MonkeyBoy122/ThermalCamara/dock_back.png

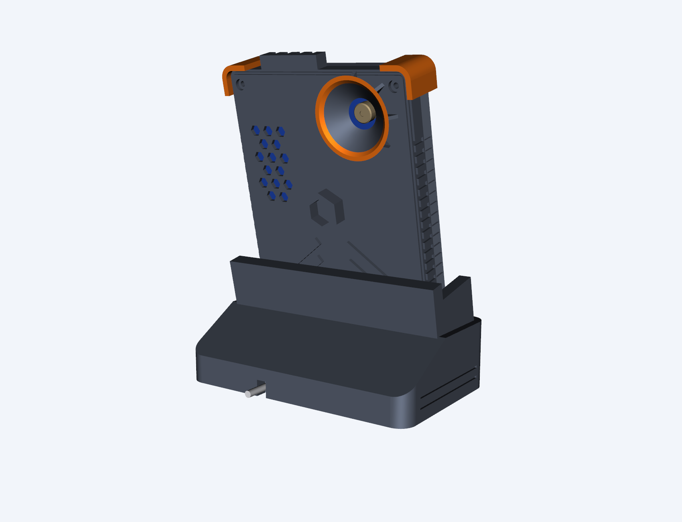
dock_back.png
