MonkeyBoy122/ThermalCamara/dock_front.png

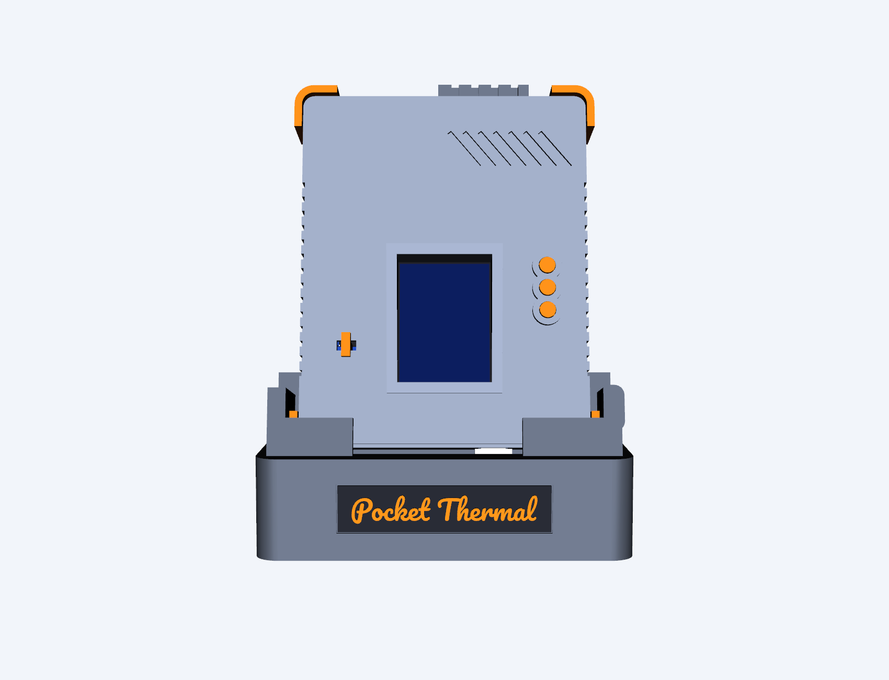
dock_front.png
