MonkeyBoy122/ThermalCamara/dock_side.png

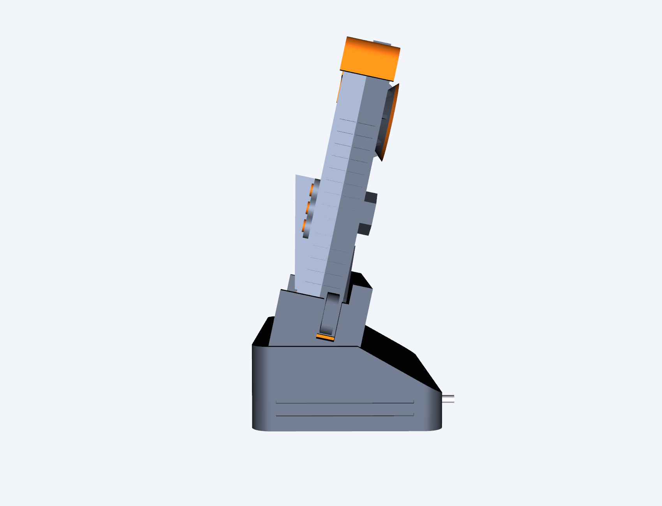
dock_side.png
