MonkeyBoy122/ThermalCamara/dock_underside.png

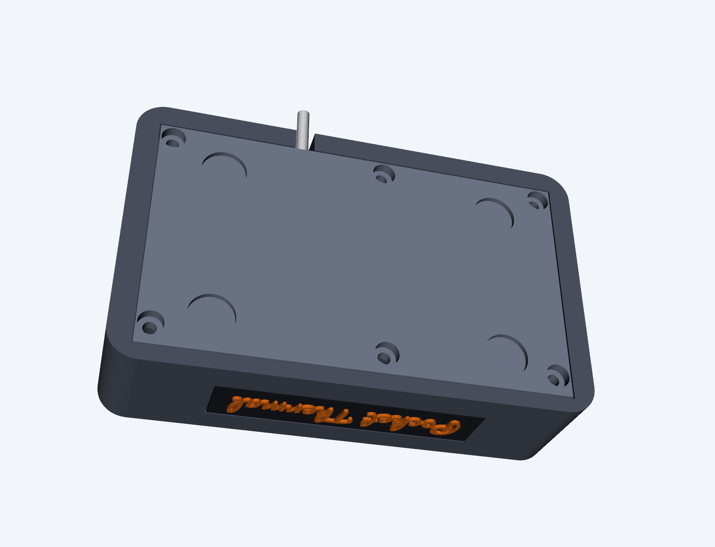
dock_underside.png
