MonkeyBoy122/ThermalCamara/enclosure_hero.png

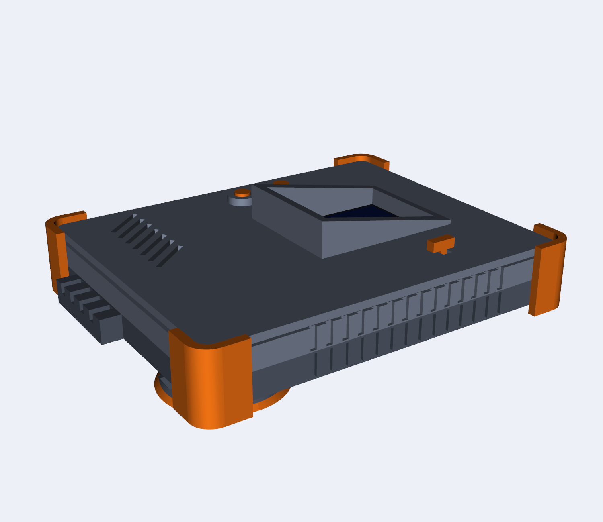
enclosure_hero.png
