MonkeyBoy122/ThermalCamara/figure12_3d_render.png

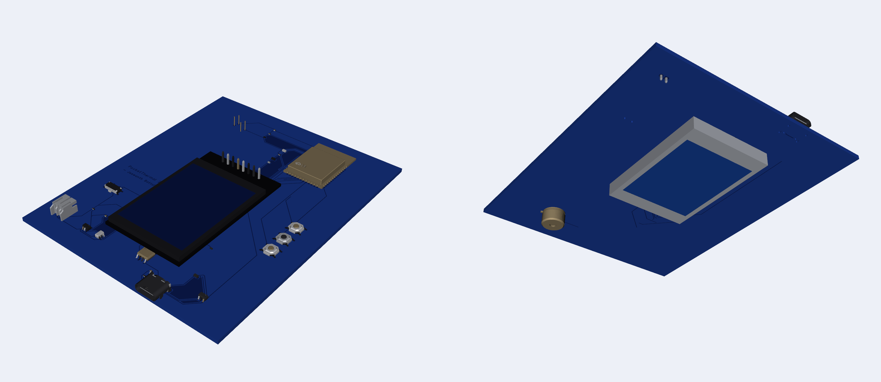
figure12_3d_render.png
