MonkeyBoy122/ThermalCamara/images/dock/empty.png

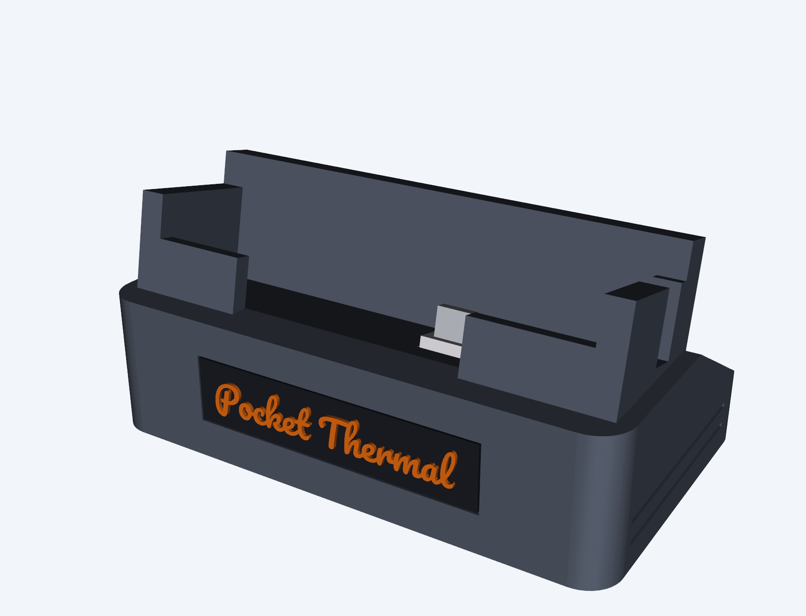
images/dock/empty.png
