MonkeyBoy122/ThermalCamara/images/dock/exploded.png

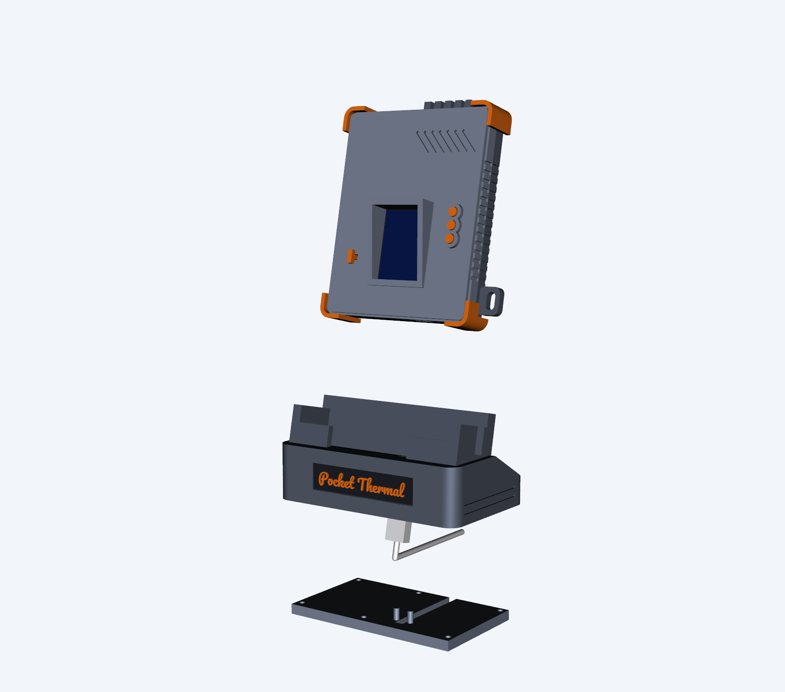
images/dock/exploded.png
