MonkeyBoy122/ThermalCamara/images/dock/nameplate.png

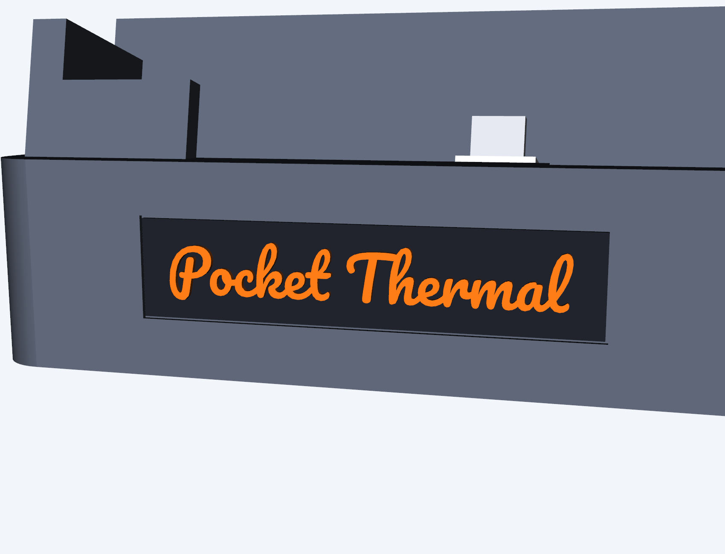
images/dock/nameplate.png
