MonkeyBoy122/ThermalCamara/images/dock/section.png

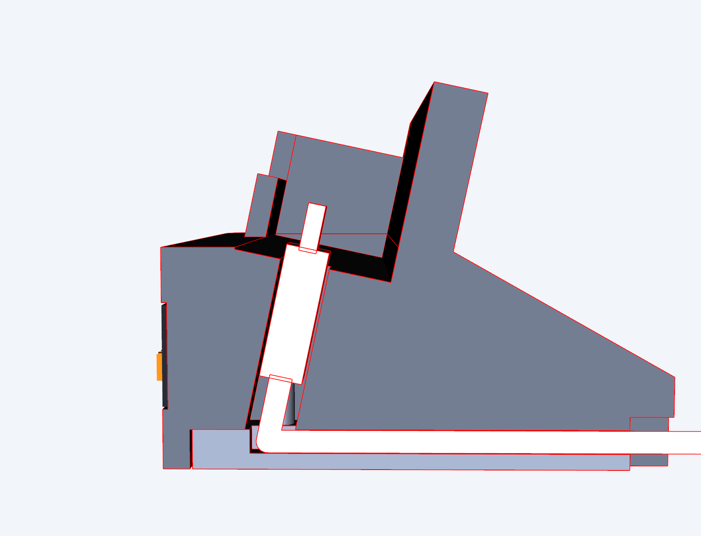
images/dock/section.png
