MonkeyBoy122/ThermalCamara/images/enclosure/back.png

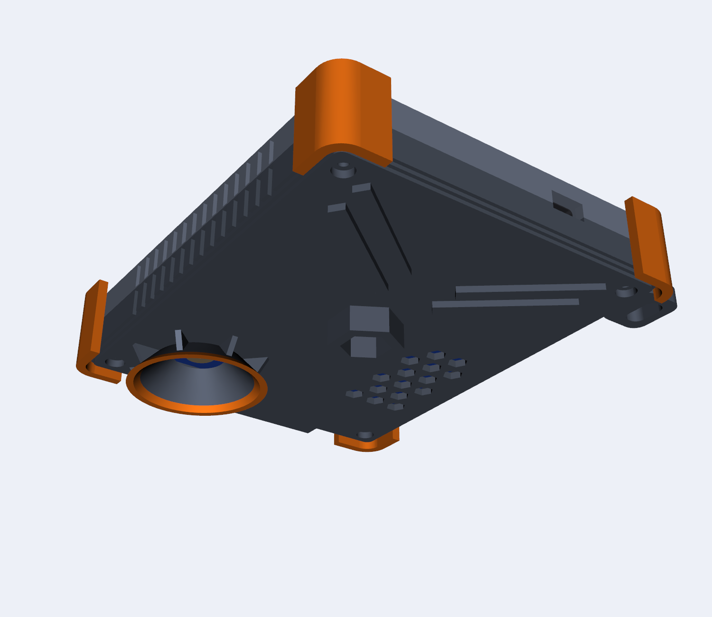
images/enclosure/back.png
