MonkeyBoy122/ThermalCamara/images/enclosure/exploded.png

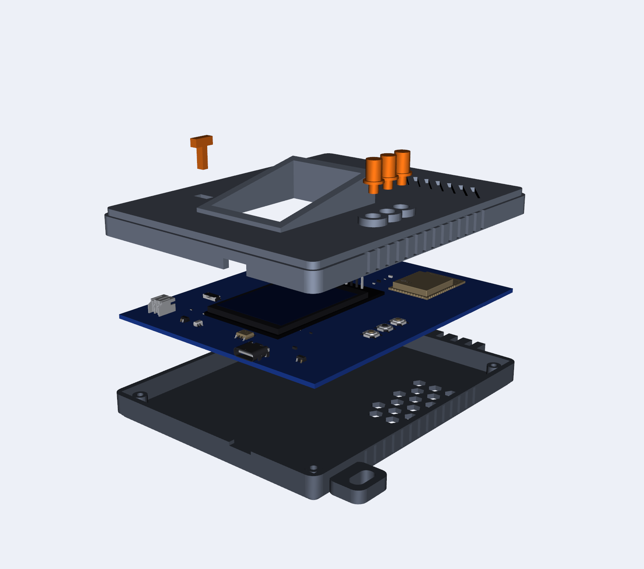
images/enclosure/exploded.png
