MonkeyBoy122/ThermalCamara/images/enclosure/front.png

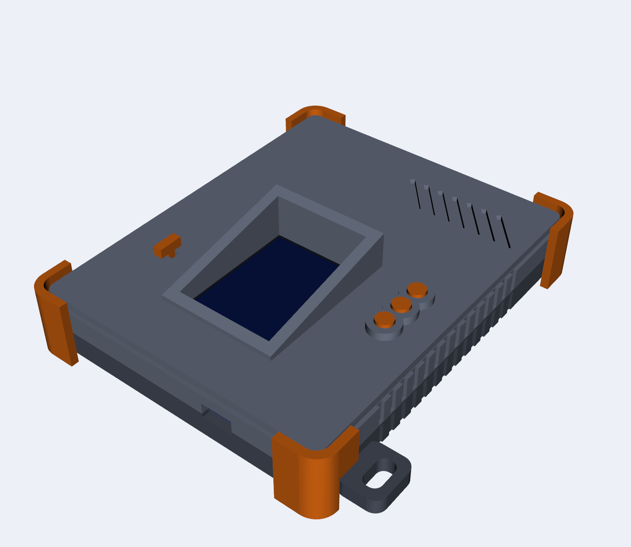
images/enclosure/front.png
