MonkeyBoy122/ThermalCamara/BOM.md

# PocketThermal – bill of materials

<!-- Generated by Half Life from project cmuvae94e0foc01sm9pq8vcqa. Edits here are overwritten on the next sync. -->
<!-- Generated: 2026-10-11T19:07:40.587Z -->

> [!NOTE]
> This parts list is mirrored from [Half Life](https://halflife.hackclub.com). Editing it here will not change the platform's copy, and the next sync overwrites this file.

| Week | Tier | Parts funding |
| --- | --- | --- |
| Week 1 | Tier 3 | $100.00 |

| Part | What it's for | Qty | Unit | Total | Vendor |
| --- | --- | --- | --- | --- | --- |
| [ESP32-S3-WROOM-1-N8R2](https://www.lcsc.com/product-detail/C2913204.html) | Wi-Fi and the main loop | 1 | $4.68 | $4.68 | [LCSC](https://www.lcsc.com/product-detail/C2913204.html) |
| [2.0" ST7789 240×320 IPS LCD](https://www.amazon.com/dp/B0H6VZD3LW) | Shows the thermal image | 1 | $7.98 | $7.98 | [Amazon](https://www.amazon.com/dp/B0H6VZD3LW) |
| [DW01A (SOT-23-6)](https://www.lcsc.com/product-detail/C359989.html) | Battery protection controller | 1 | $0.51 | $0.51 | [LCSC](https://www.lcsc.com/product-detail/C359989.html) |
| [503450 LiPo 3.7 V ~1200 mAh, JST-PH](https://www.amazon.com/dp/B09FLG39NX?plpRedirect=mhFallback) | Battery | 1 | $10.99 | $10.99 | [Amazon](https://www.amazon.com/dp/B09FLG39NX?plpRedirect=mhFallback) |
| [TP4056-42-ESOP8](https://www.lcsc.com/product-detail/C16581.html) | Charges the battery from USB-C | 1 | $0.93 | $0.93 | [LCSC](https://www.lcsc.com/product-detail/C16581.html) |
| [FS8205A (SOT-23-6)](https://www.lcsc.com/product-detail/C908265.html) | Battery protection MOSFET pair | 1 | $0.58 | $0.58 | [LCSC](https://www.lcsc.com/product-detail/C908265.html) |
| [AP2112K-3.3TRG1](https://www.lcsc.com/product-detail/C51118.html) | 3.3 V regulator | 1 | $0.86 | $0.86 | [LCSC](https://www.lcsc.com/product-detail/C51118.html) |
| [USBLC6-2SC6](https://www.lcsc.com/product-detail/C7519.html) | USB data line surge protection | 1 | $0.89 | $0.89 | [LCSC](https://www.lcsc.com/product-detail/C7519.html) |
| [USB-C 16-pin connector](https://www.lcsc.com/product-detail/C2765186.html) | Charging and USB programming | 1 | $1.43 | $1.43 | [LCSC](https://www.lcsc.com/product-detail/C2765186.html) |
| [JST S2B-PH-K-S(LF)(SN)](https://www.lcsc.com/product-detail/C173752.html) | Battery connector | 1 | $0.80 | $0.80 | [LCSC](https://www.lcsc.com/product-detail/C173752.html) |
| [MSK12C02 slide switch](https://www.lcsc.com/product-detail/C431540.html) | Power switch | 1 | $0.54 | $0.54 | [LCSC](https://www.lcsc.com/product-detail/C431540.html) |
| [5.1×5.1 mm SMD tact switch](https://www.lcsc.com/search?q=5.1x5.1+smd+tact+switch+4pin) | Trigger and menu buttons | 3 | $0.05 | $0.15 | [LCSC](https://www.lcsc.com/search?q=5.1x5.1+smd+tact+switch+4pin) |
| [0603 LED (red, green)](https://www.lcsc.com/search?q=0603+led) | Charging and standby indicators | 2 | $0.99 | $1.98 | [LCSC](https://www.lcsc.com/search?q=0603+led) |
| [8-pin 2.54 mm female header](https://www.lcsc.com/search?q=2.54mm+8p+female+header) | Plugs the LCD into the board | 1 | $0.15 | $0.15 | [LCSC](https://www.lcsc.com/search?q=2.54mm+8p+female+header) |
| [5.1 kΩ 0402 resistor](https://www.lcsc.com/search?q=5.1k+0402+resistor) | USB-C CC1 and CC2 (R1, R2) | 2 | $0.12 | $0.24 | [LCSC](https://www.lcsc.com/search?q=5.1k+0402+resistor) |
| [1 kΩ 0402 resistor](https://www.lcsc.com/search?q=1k+0402+resistor) | LED current limit (R4, R5) | 2 | $0.18 | $0.36 | [LCSC](https://www.lcsc.com/search?q=1k+0402+resistor) |
| [10 kΩ 0402 resistor](https://www.lcsc.com/search?q=10k+0402+resistor) | ESP32 reset pull-up (R8) | 1 | $0.34 | $0.34 | [LCSC](https://www.lcsc.com/search?q=10k+0402+resistor) |
| [100 kΩ 0402 resistor](https://www.lcsc.com/search?q=100k+0402+resistor) | Battery voltage divider (R9, R10) | 2 | $0.18 | $0.36 | [LCSC](https://www.lcsc.com/search?q=100k+0402+resistor) |
| [4.7 kΩ 0402 resistor](https://www.lcsc.com/search?q=4.7k+0402+resistor) | I2C pull-ups (R11, R12) | 2 | $0.17 | $0.34 | [LCSC](https://www.lcsc.com/search?q=4.7k+0402+resistor) |
| [100 nF 0402 capacitor](https://www.lcsc.com/search?q=100nF+0402+capacitor) | Decoupling and filtering (C1, C6, C7, C9, C10) | 5 | $0.09 | $0.45 | [LCSC](https://www.lcsc.com/search?q=100nF+0402+capacitor) |
| [Custom 2-layer PCB (5 boards)](https://jlcpcb.com) | The board itself | 1 | $8.50 | $8.50 | [JLCPCB](https://jlcpcb.com) |
| [2 kΩ 0402 resistor](https://www.lcsc.com/search?q=2k+0402+resistor) | Charge current set and battery protection (R3, R7) | 2 | $0.17 | $0.34 | [LCSC](https://www.lcsc.com/search?q=2k+0402+resistor) |
| [100 Ω 0402 resistor](https://www.lcsc.com/search?q=100R+0402+resistor) | Battery protection supply (R6) | 1 | $0.34 | $0.34 | [LCSC](https://www.lcsc.com/search?q=100R+0402+resistor) |
| [10 µF 0603 capacitor](https://www.lcsc.com/search?q=10uF+0603+capacitor) | Power decoupling (C2–C5, C8) | 5 | $0.12 | $0.60 | [LCSC](https://www.lcsc.com/search?q=10uF+0603+capacitor) |
| [MLX90640ESF-BAB-000-TU](https://www.lcsc.com/product-detail/Image-Sensors_Melexis-MLX90640ESF-BAB-000-TU_C488251.html) | 32×24 thermal image sensor | 1 | $23.38 | $23.38 | [LCSC](https://www.lcsc.com/product-detail/Image-Sensors_Melexis-MLX90640ESF-BAB-000-TU_C488251.html) |
| **Parts subtotal** | — | — | — | **$67.72** | — |
| **Tax & shipping** | — | — | — | **$32.15** | — |
| **Total** | — | — | — | **$99.87** | — |

$0.13 left of the tier's funding.
