MonkeyBoy122/ThermalCamara/pcb/PCB_layout_and_BOM_2026-10-10.pdf

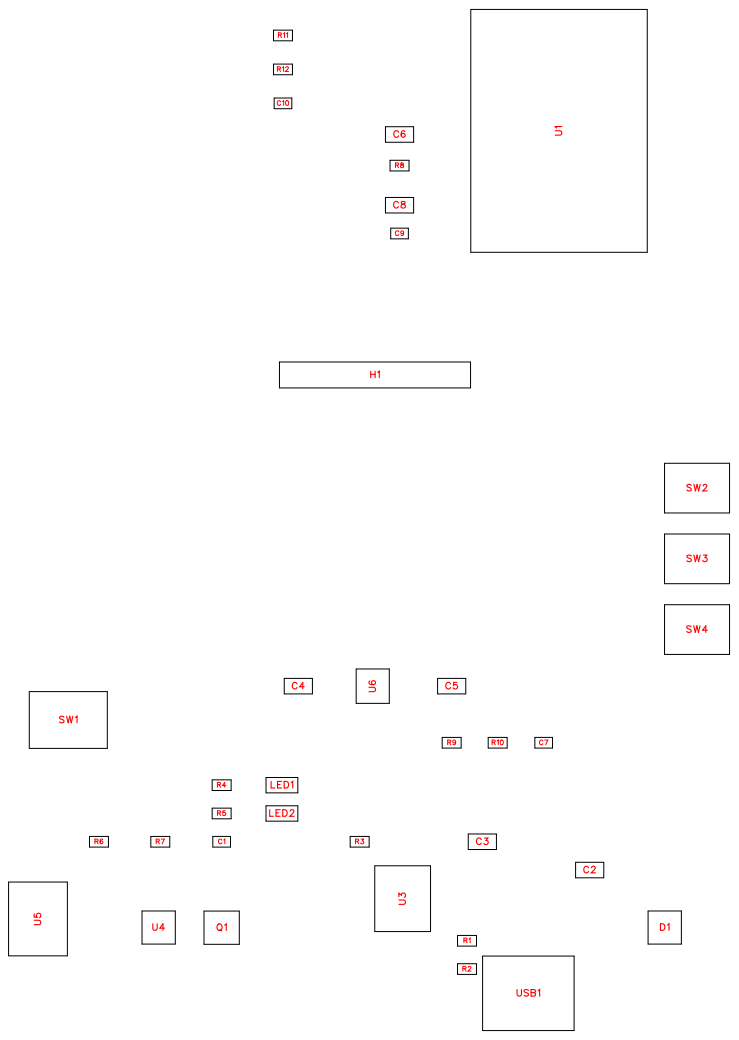
[picture p16: page 1]

U2

No. | Quantity | Comment | Designator | Footprint | Value | Manufacturer Part | Manufacturer | Supplier Part | Supplier
1 | 2 | 100nF | C1,C10 | C0402 | 100nF | CL05B104K O5NNNC | SAMSUNG( ) 三星 | C1525 | LCSC
2 | 1 | CL10A106KP 8NNNC | C2 | C0603 | | CL10A106KP 8NNNC | SAMSUNG( ) 三星 | CL10A106KP 8NNNC.1 | LCSC
3 | 4 | 10uF | C3,C4,C5,C8 | C0603 | 10uF | CL10A106KP 8NNNC | SAMSUNG( 三星 ) | C19702 | LCSC
4 | 1 | CL10A105KB 8NNNC | C6 | C0603 | | CL10A105KB 8NNNC | SAMSUNG( 三星 ) | CL10A105KB 8NNNC.1 | LCSC
5 | 2 | CL05B104K O5NNNC | C7,C9 | C0402 | | CL05B104K O5NNNC | SAMSUNG( 三星 ) | CL05B104K O5NNNC.1 | LCSC
6 | 1 | USBLC6-2S C6 | D1 | SOT-23-6_L2 .9-W1.6-P0.9 5-LS2.8-BL | | USBLC6-2S C6 | ST(意法半导 体) | C7519 | LCSC
7 | 1 | PZ254V-11-0 8P | H1 | HDR-TH_8P-P2.54-V-M | | PZ254V-11-0 8P | XFCN(兴飞 ) | C492407 | LCSC
8 | 1 | KT-0603R | LED1 | LED-SMD_L 1.6-W0.8-R-RD | | KT-0603R | KENTO | C2286 | LCSC
9 | 1 | KT-0603R | LED2 | LED-SMD_L 1.6-W0.8-R-RD | | KT-0603R | KENTO | KT-0603R.1 | LCSC
10 | 1 | FS8205 | Q1 | SOT-23-6_L2 .9-W1.6-P0.9 5-LS2.8-BR | | FS8205 | FORTUNE( 富晶 ) | C32254 | LCSC
11 | 2 | 5.1k | R1,R2 | R0402 | 5.1k | 0402WGF51 01TCE | UNI-ROYAL( 厚声 ) | C25905 | LCSC
12 | 2 | 2k | R3,R7 | R0402 | 2k | 0402WGF20 01TCE | UNI-ROYAL( 厚声 ) | C4109 | LCSC
13 | 1 | 1k | R4 | R0402 | 1k | 0402WGF10 01TCE | UNI-ROYAL( 厚声 ) | C11702 | LCSC
14 | 1 | 0402WGF10 01TCE | R5 | R0402 | | 0402WGF10 01TCE | UNI-ROYAL( ) 厚声 | 0402WGF10 01TCE.1 | LCSC
15 | 1 | 100 | R6 | R0402 | 100 | 0402WGF10 00TCE | UNI-ROYAL( ) 厚声 | C25076 | LCSC
16 | 1 | 10k | R8 | R0402 | 10k | 0402WGF10 02TCE | UNI-ROYAL( 厚声 ) | C25744 | LCSC
17 | 2 | 0402WGF10 03TCE | R9,R10 | R0402 | | 0402WGF10 03TCE | UNI-ROYAL( 厚声 ) | 0402WGF10 03TCE.1 | LCSC
18 | 1 | 4.7k | R11 | R0402 | 4.7k | 0402WGF47 01TCE | UNI-ROYAL( 厚声 ) | C25900 | LCSC
19 | 1 | 0402WGF47 01TCE | R12 | R0402 | | 0402WGF47 01TCE | UNI-ROYAL( ) 厚声 | 0402WGF47 01TCE.1 | LCSC
20 | 1 | MSK12C02 | SW1 | SW-TH_MSK 12C02 | | MSK12C02 | SHOU HAN(首韩 ) | C431540 | LCSC
21 | 3 | TS-1187A-B-A-B | SW2,SW3,SW4 | SW-SMD_4P -L5.1-W5.1-P 3.70-LS6.5-T L_H1.5 | | TS-1187A-B-A-B | XKB Connect ion(中国星坤 ) | C318884 | LCSC

22 | 1 | 2.4GHz | U1 | WIRELM-SM D_ESP32-S3 -WROOM-1 | 2.4GHz | ESP32-S3-W ROOM-1-N1 6R8 | ESPRESSIF( 乐鑫 ) | C2913202 | LCSC
23 | 1 | MLX90640E SF-BAA-000-TU | U2 | SENSOR-TH _MLX90640E SF-BAA-000-TU | | MLX90640E SF-BAA-000-TU | | C990001087 4 | LCSC
24 | 1 | TP4056-42-E SOP8 | U3 | ESOP-8_L4. 9-W3.9-P1.2 7-LS6.0-BL-E P | | TP4056-42-E SOP8 | TOPPOWER (南京拓微) | C16581 | LCSC
25 | 1 | DW01A | U4 | SOT-23-6_L2 .9-W1.6-P0.9 5-LS2.8-BL | | DW01A | PUOLOP( 迪 浦 ) | C351410 | LCSC
26 | 1 | S2B-PH-K-S( LF)(SN) | U5 | CONN-TH_S 2B-PH-K-S-L F-SN | | S2B-PH-K-S( LF)(SN) | JST | C173752 | LCSC
27 | 1 | AP2112K-3.3 TRG1 | U6 | SOT-25-5_L2 .9-W1.6-P0.9 5-LS2.8-BL | | AP2112K-3.3 TRG1 | DIODES( 美 ) 台 | C51118 | LCSC
28 | 1 | TYPE-C 16PIN 2MD(073) | USB1 | USB-C-SMD _TYPE-C-16 PIN-2MD-07 3 | | TYPE-C 16PIN 2MD(073) | SHOU HAN(首韩 ) | C2765186 | LCSC

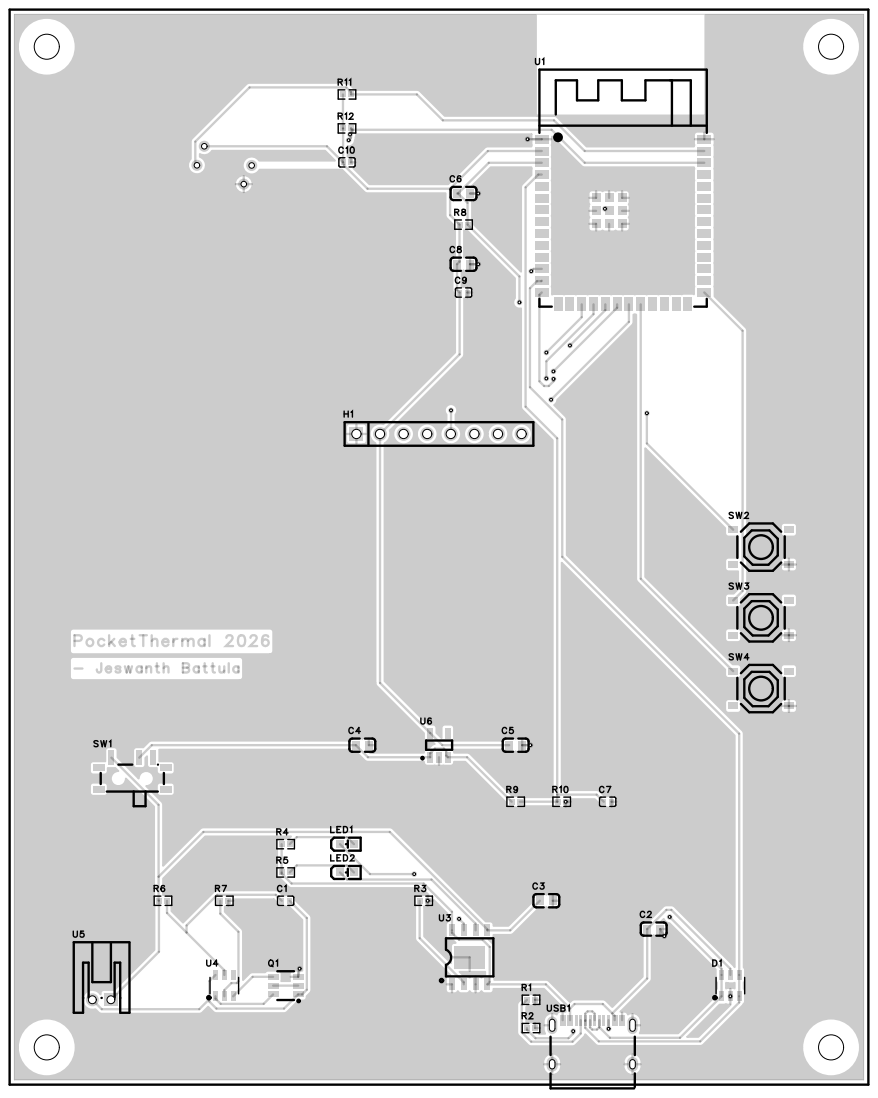
[picture p17: page 5]

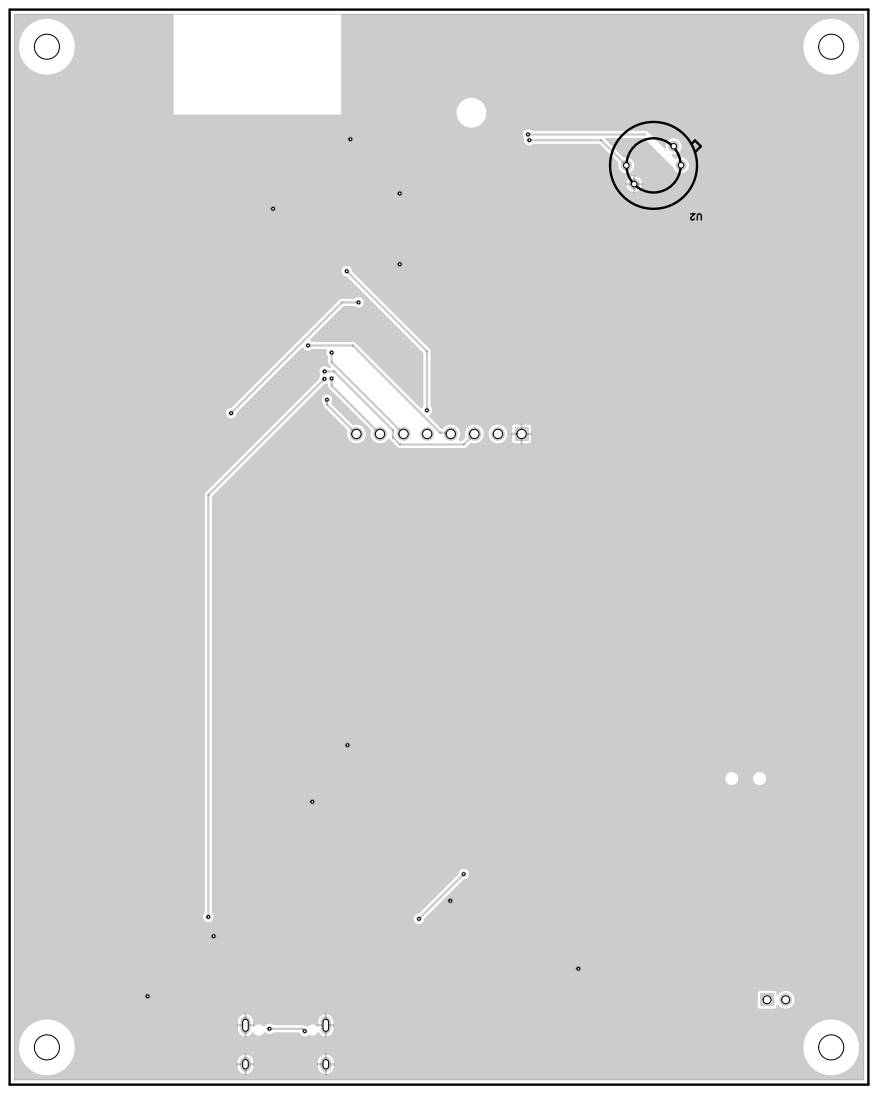
[picture p18: page 6]

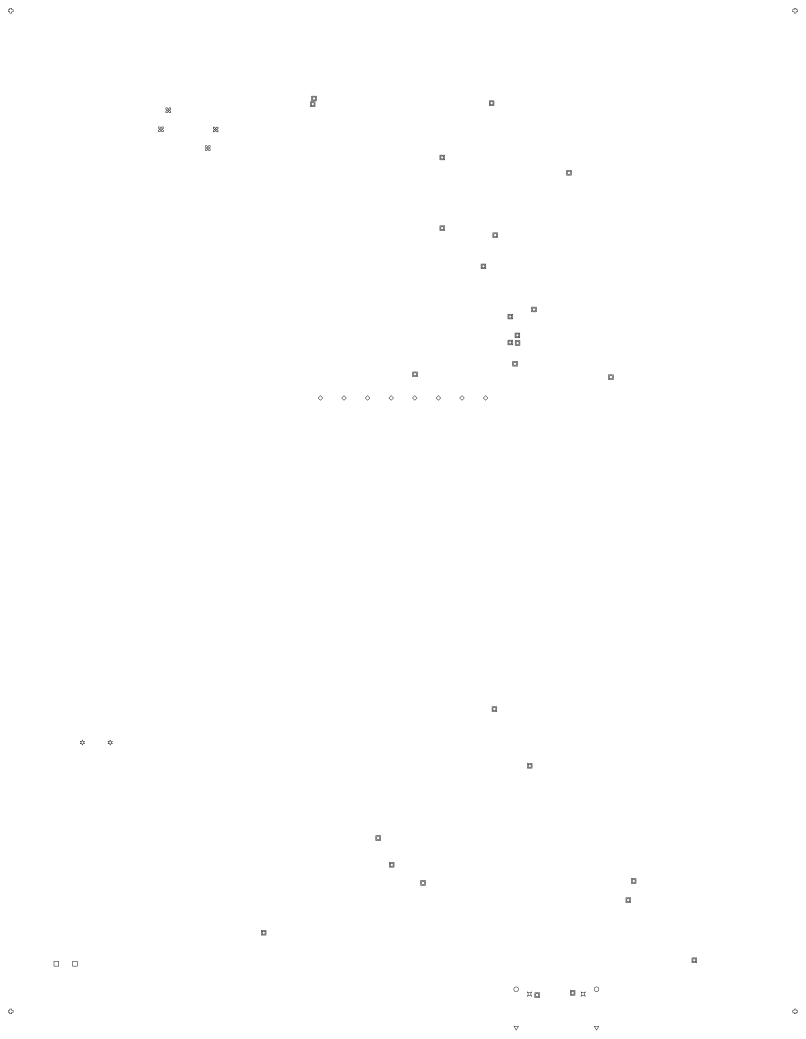
[picture p19: page 7]
