MonkeyBoy122/ThermalCamara/pcb/easyeda-export/manufacturing/assembly/BOM_Board1_PCB1_2026-10-11.csv

No. | Quantity | Comment | Designator | Footprint | Value | Manufacturer Part | Manufacturer | Supplier Part | Supplier
1 | 2 | 100nF | C1,C10 | C0402 | 100nF | CL05B104KO5NNNC | SAMSUNG(三星) | C1525 | LCSC
2 | 1 | CL10A106KP8NNNC | C2 | C0603 |  | CL10A106KP8NNNC | SAMSUNG(三星) | CL10A106KP8NNNC.1 | LCSC
3 | 4 | 10uF | C3,C4,C5,C8 | C0603 | 10uF | CL10A106KP8NNNC | SAMSUNG(三星) | C19702 | LCSC
4 | 1 | 100nF | C6 | C0603 | 100nF | CL10B104KB8NNNC | SAMSUNG(三星) | C1590 | LCSC
5 | 2 | CL05B104KO5NNNC | C7,C9 | C0402 |  | CL05B104KO5NNNC | SAMSUNG(三星) | CL05B104KO5NNNC.1 | LCSC
6 | 1 | USBLC6-2SC6 | D1 | SOT-23-6_L2.9-W1.6-P0.95-LS2.8-BL |  | USBLC6-2SC6 | ST(意法半导体) | C7519 | LCSC
7 | 1 | PZ254V-11-08P | H1 | HDR-TH_8P-P2.54-V-M |  | PZ254V-11-08P | XFCN(兴飞) | C492407 | LCSC
8 | 1 | KT-0603R | LED1 | LED-SMD_L1.6-W0.8-R-RD |  | KT-0603R | KENTO | C2286 | LCSC
9 | 1 | KT-0603R | LED2 | LED-SMD_L1.6-W0.8-R-RD |  | KT-0603R | KENTO | KT-0603R.1 | LCSC
10 | 1 | FS8205 | Q1 | SOT-23-6_L2.9-W1.6-P0.95-LS2.8-BR |  | FS8205 | FORTUNE(富晶) | C32254 | LCSC
11 | 2 | 5.1kΩ | R1,R2 | R0402 | 5.1kΩ | 0402WGF5101TCE | UNI-ROYAL(厚声) | C25905 | LCSC
12 | 2 | 2kΩ | R3,R7 | R0402 | 2kΩ | 0402WGF2001TCE | UNI-ROYAL(厚声) | C4109 | LCSC
13 | 1 | 1kΩ | R4 | R0402 | 1kΩ | 0402WGF1001TCE | UNI-ROYAL(厚声) | C11702 | LCSC
14 | 1 | 0402WGF1001TCE | R5 | R0402 |  | 0402WGF1001TCE | UNI-ROYAL(厚声) | 0402WGF1001TCE.1 | LCSC
15 | 1 | 100Ω | R6 | R0402 | 100Ω | 0402WGF1000TCE | UNI-ROYAL(厚声) | C25076 | LCSC
16 | 1 | 10kΩ | R8 | R0402 | 10kΩ | 0402WGF1002TCE | UNI-ROYAL(厚声) | C25744 | LCSC
17 | 2 | 0402WGF1003TCE | R9,R10 | R0402 |  | 0402WGF1003TCE | UNI-ROYAL(厚声) | 0402WGF1003TCE.1 | LCSC
18 | 1 | 4.7kΩ | R11 | R0402 | 4.7kΩ | 0402WGF4701TCE | UNI-ROYAL(厚声) | C25900 | LCSC
19 | 1 | 0402WGF4701TCE | R12 | R0402 |  | 0402WGF4701TCE | UNI-ROYAL(厚声) | 0402WGF4701TCE.1 | LCSC
20 | 1 | MSK12C02 | SW1 | SW-TH_MSK12C02 |  | MSK12C02 | SHOU HAN(首韩) | C431540 | LCSC
21 | 3 | TS-1187A-B-A-B | SW2,SW3,SW4 | SW-SMD_4P-L5.1-W5.1-P3.70-LS6.5-TL_H1.5 |  | TS-1187A-B-A-B | XKB Connection(中国星坤) | C318884 | LCSC
22 | 1 | 2.4GHz | U1 | WIRELM-SMD_ESP32-S3-WROOM-1 | 2.4GHz | ESP32-S3-WROOM-1-N16R8 | ESPRESSIF(乐鑫) | C2913202 | LCSC
23 | 1 | MLX90640ESF-BAA-000-TU | U2 | SENSOR-TH_MLX90640ESF-BAA-000-TU |  | MLX90640ESF-BAA-000-TU |  | C9900010874 | LCSC
24 | 1 | TP4056-42-ESOP8 | U3 | ESOP-8_L4.9-W3.9-P1.27-LS6.0-BL-EP |  | TP4056-42-ESOP8 | TOPPOWER(南京拓微) | C16581 | LCSC
25 | 1 | DW01A | U4 | SOT-23-6_L2.9-W1.6-P0.95-LS2.8-BL |  | DW01A | PUOLOP(迪浦) | C351410 | LCSC
26 | 1 | S2B-PH-K-S(LF)(SN) | U5 | CONN-TH_S2B-PH-K-S-LF-SN |  | S2B-PH-K-S(LF)(SN) | JST | C173752 | LCSC
27 | 1 | AP2112K-3.3TRG1 | U6 | SOT-25-5_L2.9-W1.6-P0.95-LS2.8-BL |  | AP2112K-3.3TRG1 | DIODES(美台) | C51118 | LCSC
28 | 1 | TYPE-C 16PIN 2MD(073) | USB1 | USB-C-SMD_TYPE-C-16PIN-2MD-073 |  | TYPE-C 16PIN 2MD(073) | SHOU HAN(首韩) | C2765186 | LCSC
