MonkeyBoy122/ThermalCamara/enclosure_only.step

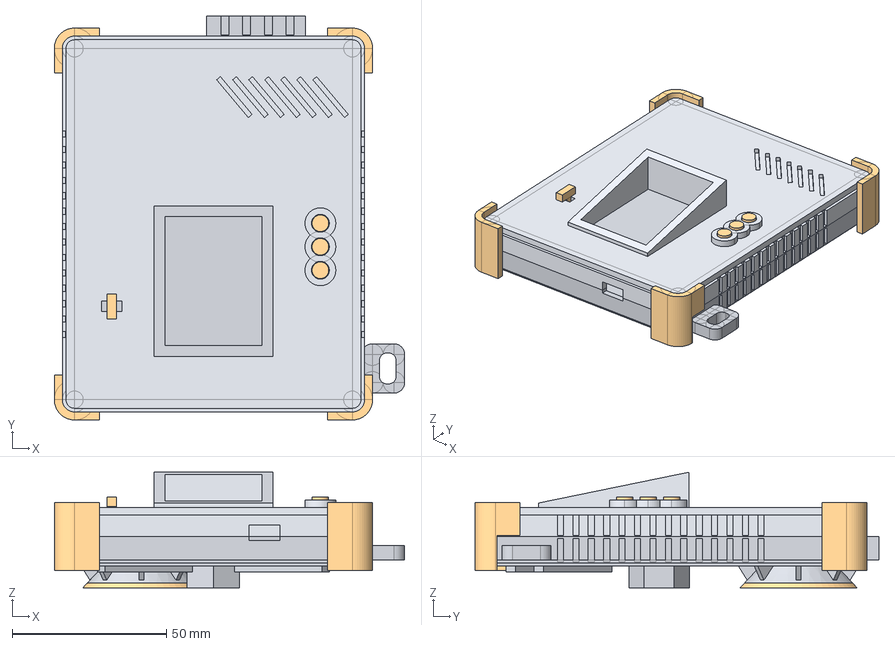
[picture p20: CAD file, 2026-10-11]
enclosure_only.step
113.6 x 131.0 x 37.5 mm
