MonkeyBoy122/ThermalCamara/dock_only.step

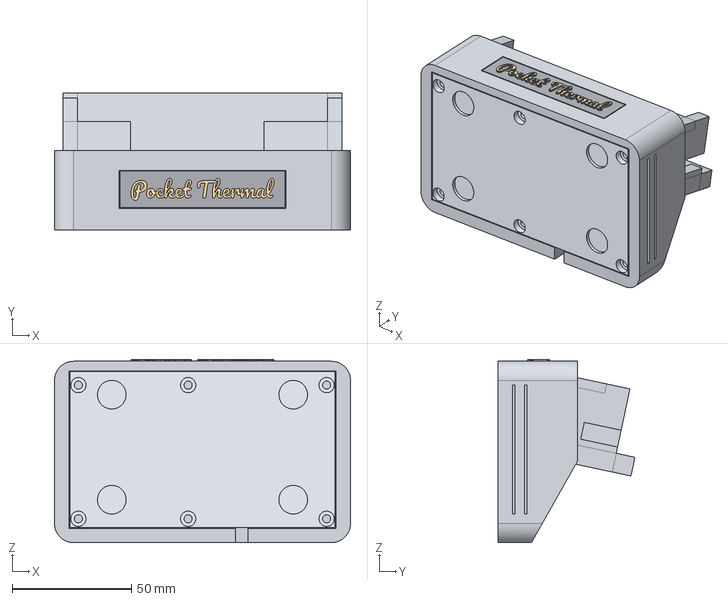
[picture p21: CAD file, 2026-10-11]
dock_only.step
124.0 x 57.3 x 76.8 mm
