MonkeyBoy122/ThermalCamara/dock_with_camera_enclosure_and_cable.step

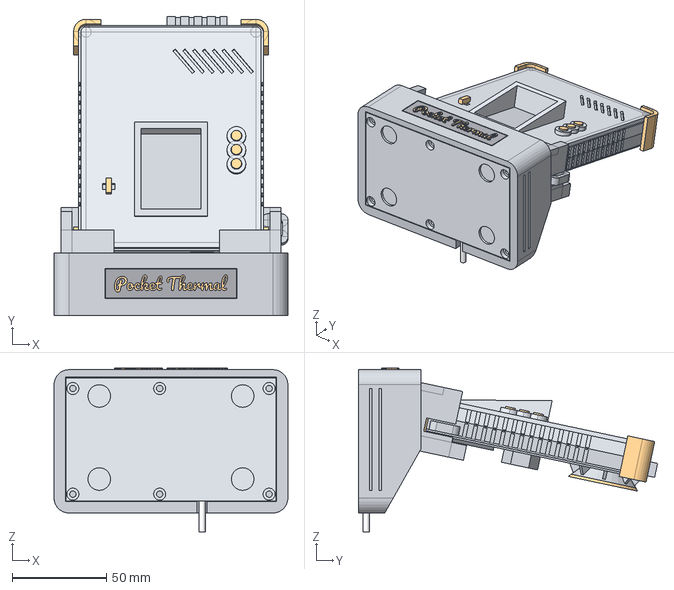
[picture p22: CAD file, 2026-10-11]
dock_with_camera_enclosure_and_cable.step
124.0 x 158.6 x 86.8 mm
