MonkeyBoy122/ThermalCamara/dock_build_step1.png

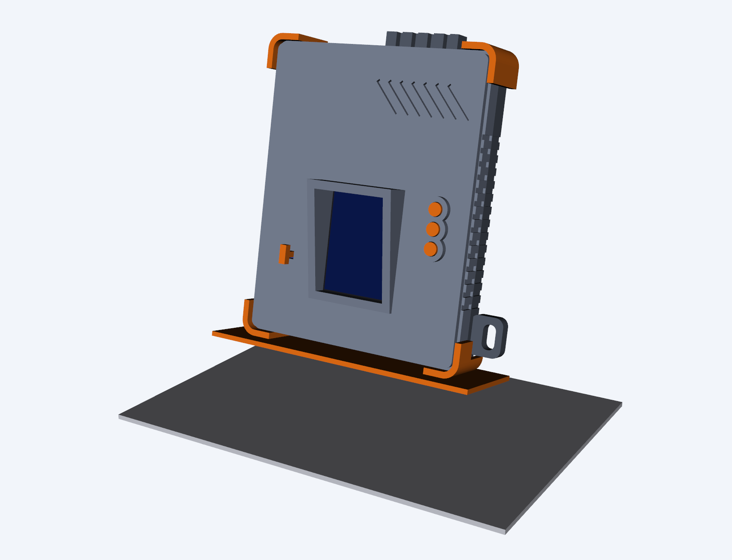
dock_build_step1.png
