MonkeyBoy122/ThermalCamara/dock_build_step3.png

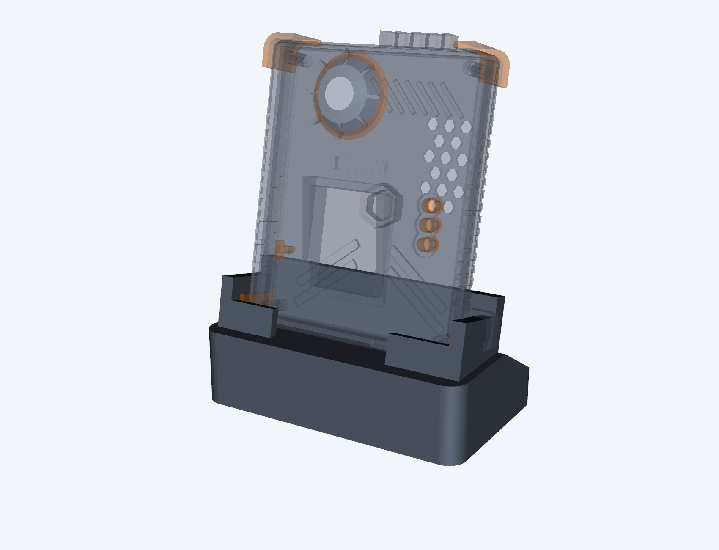
dock_build_step3.png
