MonkeyBoy122/ThermalCamara/dock_build_step5.png

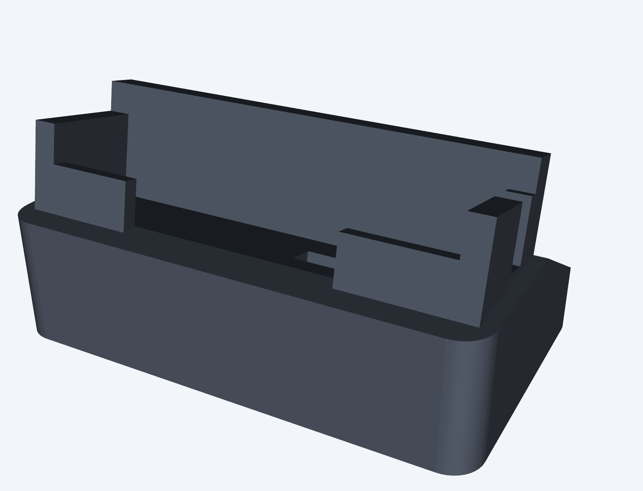
dock_build_step5.png
