MonkeyBoy122/ThermalCamara/dock_build_step6.png

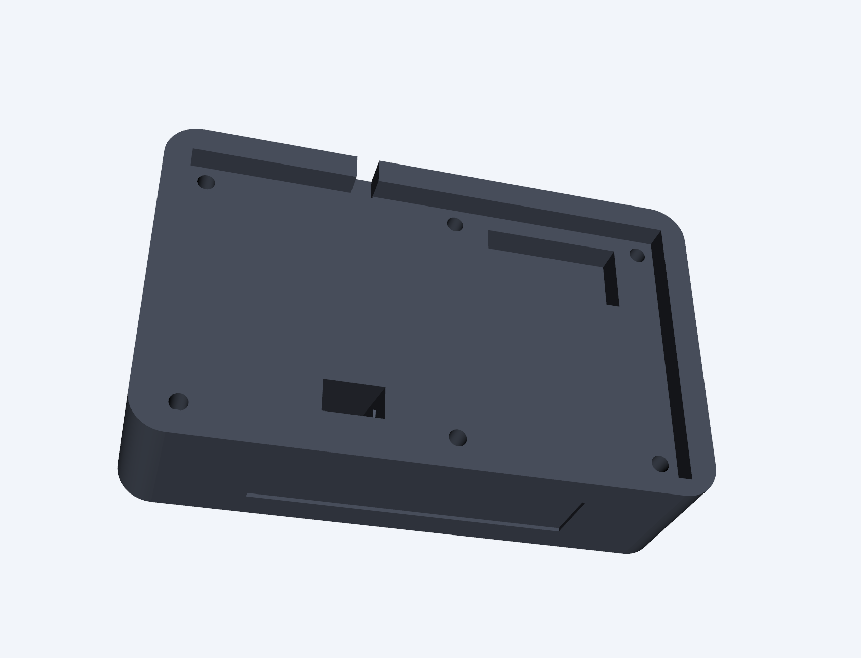
dock_build_step6.png
