MonkeyBoy122/ThermalCamara/dock_build_step7.png

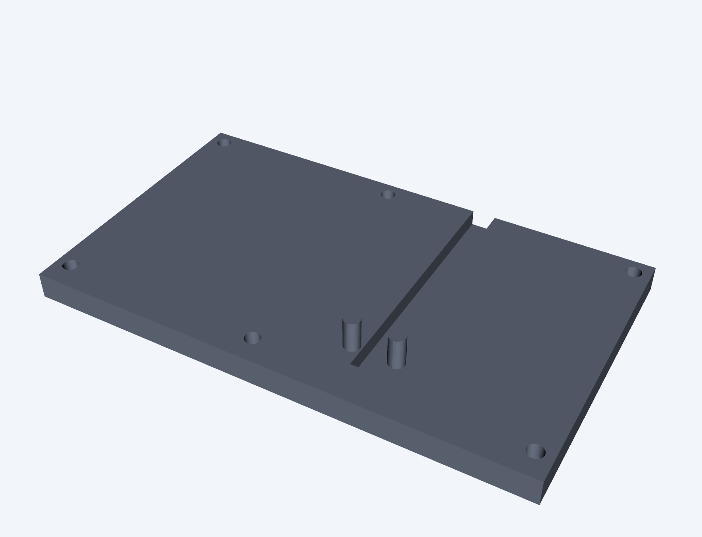
dock_build_step7.png
