MonkeyBoy122/ThermalCamara/enclosure_build_hour01.png

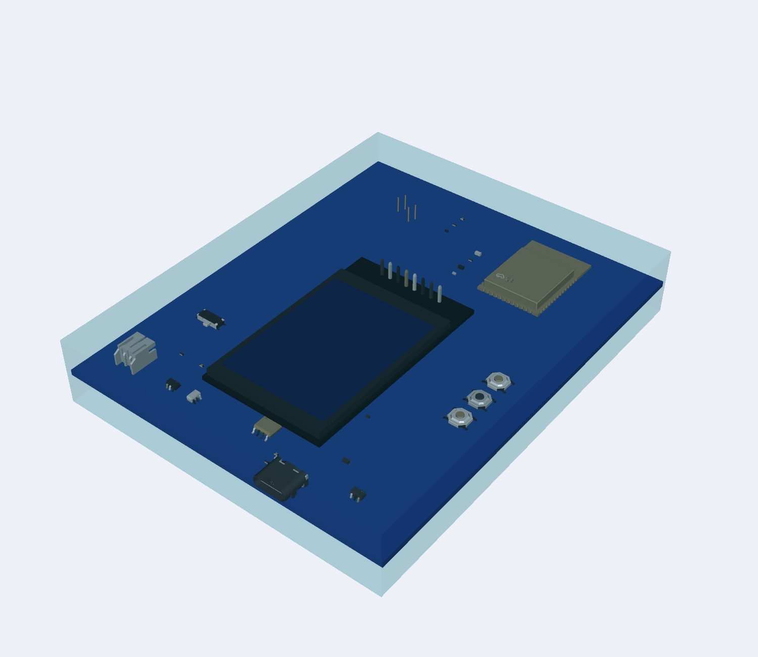
enclosure_build_hour01.png
