MonkeyBoy122/ThermalCamara/enclosure_build_hour02.png

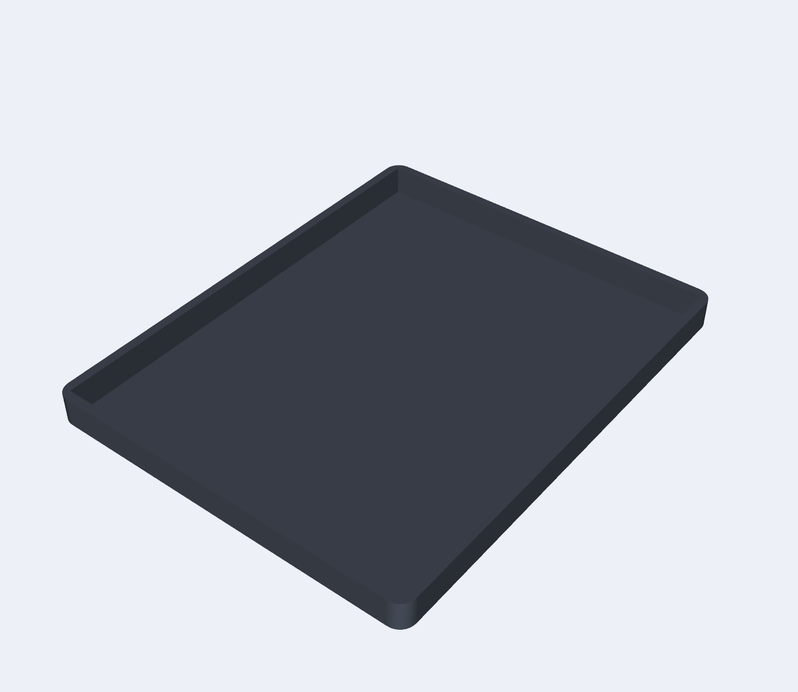
enclosure_build_hour02.png
