MonkeyBoy122/ThermalCamara/enclosure_build_hour08.png

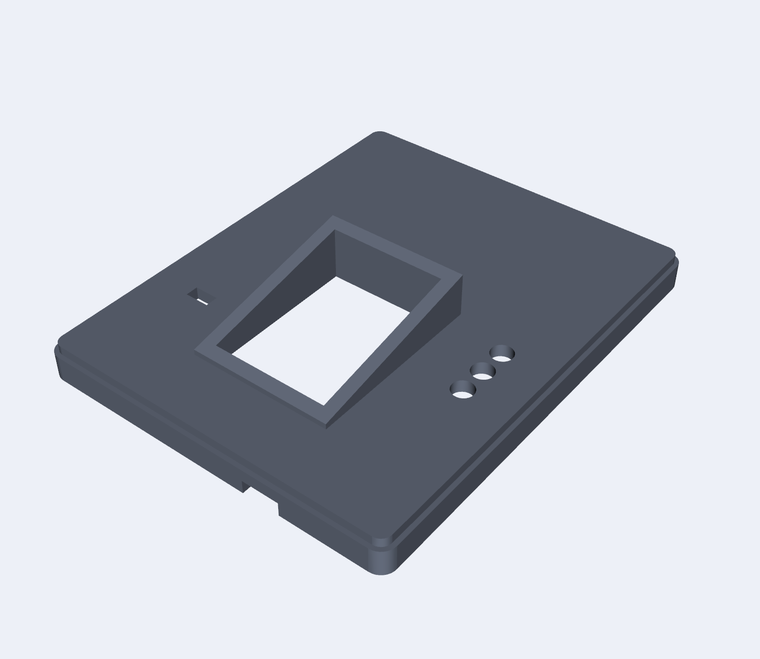
enclosure_build_hour08.png
