MonkeyBoy122/ThermalCamara/images/enclosure/build/hour04.png

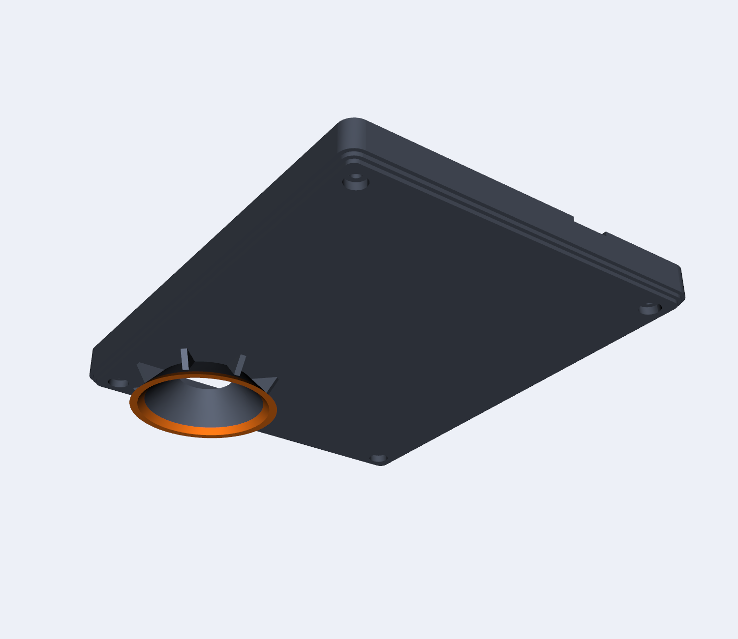
images/enclosure/build/hour04.png
