MonkeyBoy122/ThermalCamara/JOURNAL.md

# PocketThermal – devlog

<!-- Generated by Half Life from project cmuvae94e0foc01sm9pq8vcqa. Edits here are overwritten on the next sync. -->
<!-- Generated: 2026-10-10T06:33:12.076Z -->

> [!NOTE]
> This devlog is mirrored from [Half Life](https://halflife.hackclub.com). Editing it here will not change the platform's copy, and the next sync overwrites this file.

> A handheld thermal camera built around an MLX90640 32x24 IR sensor and an ESP32-S3. It streams the thermal image to a 2.0" IPS display with interpolation and a color palette, and runs off a single-cell LiPo with USB-C charging. I'm designing the custom 2-layer PCB myself, with the sensor kept away from heat sources like the regulator and charger, and a 3D-printed enclosure around it.

| Week | Tier | Hours logged | Entries |
| --- | --- | --- | --- |
| Week 1 | Tier 3 | 45h | 4 |

## Contents

1. [2026-10-07 – October 6: Finished the schematic for my handheld thermal camera](#2026-10-07-october-6-finished-the-schematic-for-my-handheld-)
2. [2026-10-08 – October 7: Placed and routed the PCB for my handheld thermal camera](#2026-10-08-october-7-placed-and-routed-the-pcb-for-my-handhe)
3. [2026-10-09 – Hour 1: Measured the board. I put the PCB, the LCD and the battery into one assembly and wrapped them in a clear box. This showed the space the casing has to cover: about 93 × 117 mm, with 8 mm below](#2026-10-09-hour-1-measured-the-board-i-put-the-pcb-the-lcd-a)
4. [2026-10-10 – Hour 1: Setting the lean and the floor](#2026-10-10-hour-1-setting-the-lean-and-the-floor)

## Design

### 2026-10-07 – October 6: Finished the schematic for my handheld thermal camera

**9h**

October 6: Finished the schematic for my handheld thermal camera

I spent 9 hours on the full schematic in EasyEDA Pro before drawing any traces. I haven't ordered or built the PCB yet, so I wanted every connection checked on paper first.

The camera uses an MLX90640 thermal sensor (32×24 pixels) and an ESP32-S3. A 2.0" screen shows the image, and a single LiPo battery powers everything, charged over USB-C.



I split the circuit into blocks:

USB-C input. Two 5.1 kΩ resistors on the CC pins tell chargers to supply 5 V. A USBLC6-2SC6 protects the data lines, which go straight to the ESP32's built-in USB pins (IO19/IO20).



Charging. A TP4056 charges the battery. A 2 kΩ resistor on its PROG pin sets about 0.6 A. Two red LEDs show charging and full, each through 1 kΩ from the 5 V line.



Battery protection. A DW01A and an FS8205A guard against over-discharge, over-charge and short circuits. I followed the standard wiring: 100 Ω and 100 nF on the supply, and 2 kΩ on the sense pin.



Power. A slide switch connects the battery to the system. An AP2112K steps that down to 3.3 V with 10 µF capacitors on both sides.



Sensor. The MLX90640 uses I2C on IO1/IO2 with 4.7 kΩ pull-ups and a 100 nF capacitor close by.



Screen. An 8-pin header carries SPI to the LCD: SCK on IO12, MOSI on IO11, CS on IO10, DC on IO9, RST on IO8 and backlight on IO13. I used the ESP32-S3's default SPI pins.



Controls. Reset, boot and trigger buttons, plus a battery-voltage divider on IO4. I picked IO4 because it's safe to read while Wi-Fi is running.



All of these connect to the ESP32-S3 module.



While checking my work I found some challenges I faced-

1. Getting the battery circuit right. The charger and the protection chips (DW01A and FS8205A) have to be wired together in a specific way, and the datasheet pin names didn't map obviously to my schematic. I traced the current path from the battery through the protection MOSFETs to ground to check it.

2. Checking the thermal sensor's pins. The MLX90640 comes in a small 4-pin metal can. When I compared my schematic symbol to the datasheet, the pin order didn't match: the datasheet lists SDA, VDD, GND, SCL, but my symbol had them in a different order. If I had routed the board as it was, the data line would have landed on the power pin.

3. Running from USB. My schematic charges the battery from USB, but the rest of the circuit only runs from the battery. That means the camera can't be powered or flashed from USB alone. I can't just connect USB power to the system, because it would push 5 V into the battery.

4. Matching the screen's pins. Different 2" LCD modules use different pin orders. My header follows one specific order (GND, 3V3, SCK, MOSI, RST, DC, CS, BL), so I have to buy a module with that order.

5. Choosing ESP32 pins. I wanted pins that work with Wi-Fi on, so I put the battery sense on IO4, which is safe to read while Wi-Fi runs. I also used the ESP32-S3's default SPI pins for the screen, and its built-in USB pins for the USB data lines.

Next I'll finish the layout, run the design-rule check.
Time spent this session: 9 hours

### 2026-10-08 – October 7: Placed and routed the PCB for my handheld thermal camera

**13h**

October 7: Placed and routed the PCB for my handheld thermal camera

I spent 13 hours turning my schematic into a real PCB layout in EasyEDA Pro. The board is about 92 × 116 mm, and every part from the schematic is now placed and connected.



Hours 1-2: Planning the layout and the USB-C end
I started by deciding where the big parts go. The USB-C connector sits on the bottom edge so the cable plugs in from outside, and it hangs slightly past the board edge. I put the ESD chip (D1) right next to the connector, with the two CC resistors (R1 and R2) beside it. The TP4056 charger (U3) is next to those, so the 5 V traces stay short.





Hours 3-4: Battery, protection and power switch
I grouped the battery parts together on the lower left. The battery connector (U5) has the DW01A (U4) and the FS8205 (Q1) next to it, with their small resistors and capacitor close by so the protection traces are short. The slide switch (SW1) sits nearby, and the two LEDs sit beside the charger resistors (R4 and R5). I also added my name and the project title on the silkscreen.







Hours 5-7: ESP32 and the thermal sensor
The ESP32-S3 module is in the top right with its antenna toward the board's top edge. I placed its small capacitors and the enable resistor (C6, C8, C9, R8) right beside its pins. The MLX90640 is in the top left and mounts on the bottom of the board, with its metal can facing out the back and its pins coming through to the top. I put the I2C pull-up resistors (R11, R12) and the 100 nF capacitor (C10) on the path between the sensor and the ESP32 and routed the data lines through them.





Hours 8-9: Buttons and the screen header
The three buttons (reset, boot and trigger) line up along the right edge, so a thumb can reach them. The 8-pin LCD header is in the middle of the board, and the screen will sit on top of it. I routed the SPI lines from the ESP32 down to the header.





Hours 10-11: Routing and copper pour
I routed the remaining signals, widened the power traces, and filled the empty space with copper pour so the board has a solid ground. The bottom layer is mostly pour, with only a few traces. I checked the board in 3D from both sides to make sure the sensor can sticks out the back and nothing collides.



Hour 12: Final checks
I went over the layout against the schematic and looked for problems.



Hour 13: Full Display + PCB
Added a CAD of the screen to finish the look of the PCB



Next steps:
- Add a keepout under the ESP32 antenna. Right now there's copper pour under it, and the antenna needs it clear.
- Re-check the MLX90640 pin order between the schematic and the footprint.
- Add mounting holes and trim the board size.
- Add a path to power the circuit from USB.
- Run the design-rule check
-make a CAD model for the casing

Time spent this session: 13 hours

### 2026-10-09 – Hour 1: Measured the board. I put the PCB, the LCD and the battery into one assembly and wrapped them in a clear box. This showed the space the casing has to cover: about 93 × 117 mm, with 8 mm below

**13h**

Hour 1: Measured the board. I put the PCB, the LCD and the battery into one assembly and wrapped them in a clear box. This showed the space the casing has to cover: about 93 × 117 mm, with 8 mm below the board and 11 mm above it.



Hour 2: Blank back shell. I made the back tray with rounded corners, 2.4 mm walls and a stepped chamfer on the bottom edge. I left it plain so I could check the walls.



Hour 3: Posts, sensor window and USB-C. I added four corner screw posts, a round window for the thermal sensor, and a rectangular cutout for the USB-C port.



Hour 4: Sensor horn. The sensor sees about 110° × 75°, so a plain hole would block its view. I built a flared funnel around the window, added 8 triangular fins to strengthen it, and put an orange trim ring on the tip.



Hour 5: Vents and armor bars. I cut a hex vent field through the back floor, added chevron armor bars on the back face and cut grip grooves down both sides.



Hour 6: Eye, tripod boss and rail. I added a lanyard eye on the right side and a slotted accessory rail on the top edge. I also added a hexagonal boss for a 1/4"-20 tripod nut. The nut pocket stops short of the floor so a screw can’t reach the battery.



Hour 7: Blank front bezel. I made the matching front plate with an LCD window, three button holes, a slider slot and a USB-C cutout.



Hour 8: LCD visor. I added a wedge-shaped sun-visor around the LCD window, tall on the top edge and sloping down toward the bottom.



Hour 9: Guard pill and grooves. I added a raised guard pill around the three buttons and cut diagonal vent grooves above the ESP32. I also cut grip grooves on the side walls of the bezel.



Hour 10: Caps and slider. I made three tall orange button caps and a slider knob with a fin on top. Each cap has a wide inner flange so it can’t pull out through its hole. The knob drops in from above.



Hour 11: Corner bumpers. I added four orange corner bumpers meant to be printed in TPU. They wrap the corners and leave the lanyard eye free. At the bottom-right I had to trim the bumper so it didn’t collide with the eye.



Hour 12: Exploded view. I pulled the model apart to check the order: back shell, board with LCD and battery, front bezel, then the caps. It confirmed that the parts stack and the caps and knob can be inserted.



Hour 13: Final render and export. I checked every part as a valid solid, checked the nut pocket is open, and exported the STEP files. This is the finished back view.



Total Hours Worked = 13 Hours

### 2026-10-10 – Hour 1: Setting the lean and the floor

**10h**

Hour 1: Setting the lean and the floor

The camera’s USB-C port is on its bottom edge, so the dock has to stand the camera upright with the port pointing down onto an Apple USB-C plug. I started with a floor plane and tilted the camera model back 12°, so the screen is readable and the camera leans against the rear wall. The floor sits at the bottom of the camera’s four corner bumpers, so the camera’s weight rests on the bumpers and never on the connector.



Hour 2: Wedge base

I modelled a rounded-corner base that is tall at the front, with a long ramp sloping down at the back. When the camera leans back, its center of mass ends up behind the cradle, and the ramp gives the dock enough footprint to keep it from tipping. I kept the camera ghosted above the base to check the proportions.



Hour 3: Walls

I added the rear wall, two side walls and two short front tabs. I built them in the camera’s own tilted frame so they stay square to the floor, then fused them onto the base. The front is open between the two tabs so the camera lifts out with a finger.



Hour 4: Pocket and lanyard notch

I cut the pocket with 0.8 mm of clearance around the camera and its bumpers. I also cut a notch in the right wall so the lanyard eye clears the dock. Then I put the camera in to check that it seats and leans back as planned.



Hour 5: Plug channel

I cut a tilted channel straight down from the camera’s USB-C opening, so the camera drops straight onto the plug. I added four small ribs on the channel walls to grip the plug body.



Hour 6: Underside

On the bottom I cut a recess for the base plate, a weight bay, six M3 insert holes and a cable exit through the rear edge. I also added grip lines on the sides and a recess on the front for the name plate.



Hour 7: Base plate

The plate screws on from below and carries the cable. It has a groove that routes the cable to the rear and two small posts that hold the plug up from below. It also has six screw holes and four rubber-foot pockets.



Hour 8: Checking the fit

I added a reference Apple USB-C plug and cable and cut a section through the plug to see how everything sits. The cable runs down the channel and out through the groove at the back. An overlap check on the dock, camera case, plug and cable found no collisions. The ribs overlap the plug by about 5 mm³, which is the intended grip.



Hour 9-10: Name plate and final dock

I put “Pocket Thermal” on the front in cursive, as raised orange letters on a dark recessed plate. Then I exported the STEP files, one with the dock alone and one with the dock, camera enclosure and cable.





Final Hours this session: 10
