MonkeyBoy122/ThermalCamara/pcb/Schematic_2026-10-06.pdf

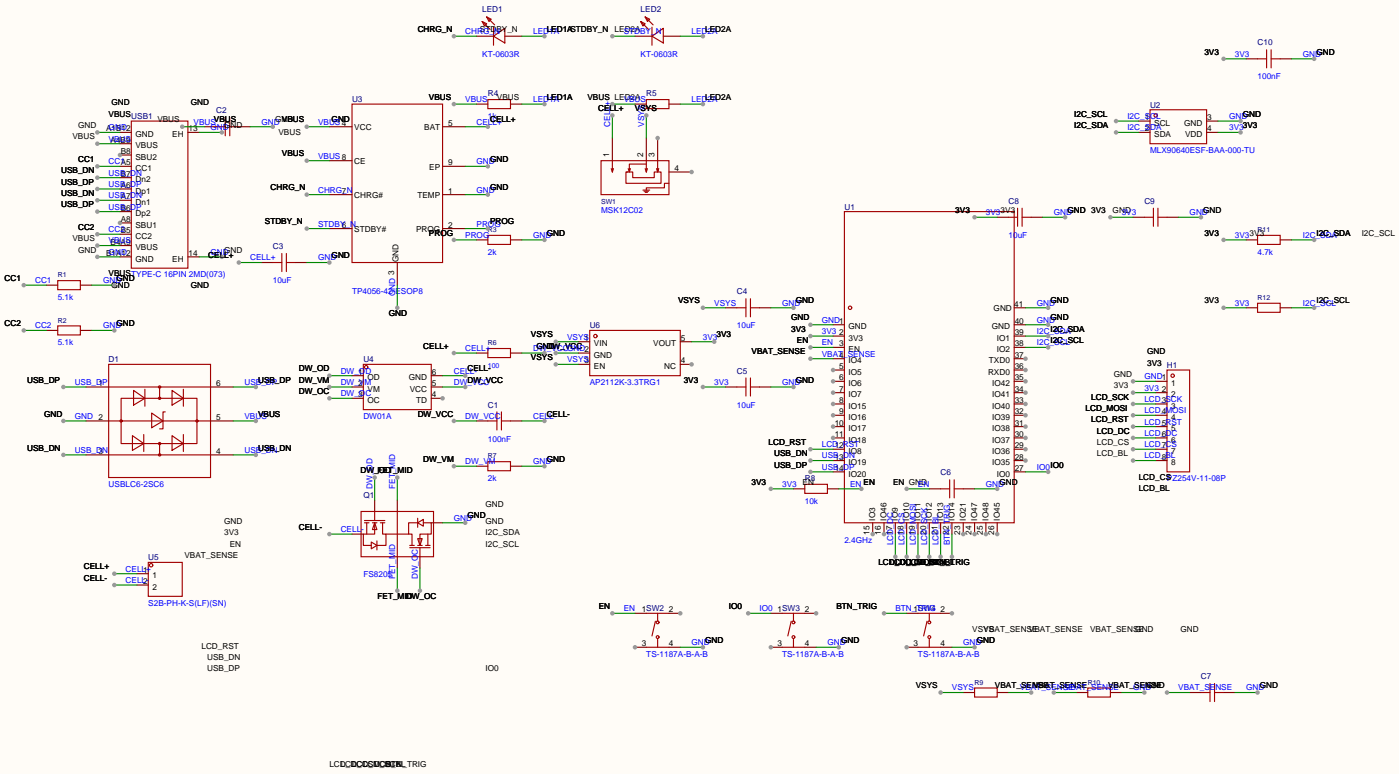
[picture p32: page 1]
