MonkeyBoy122/ThermalCamara/pcb/easyeda-export/hardware/schematic/SCH_Schematic1_2026-10-11.pdf

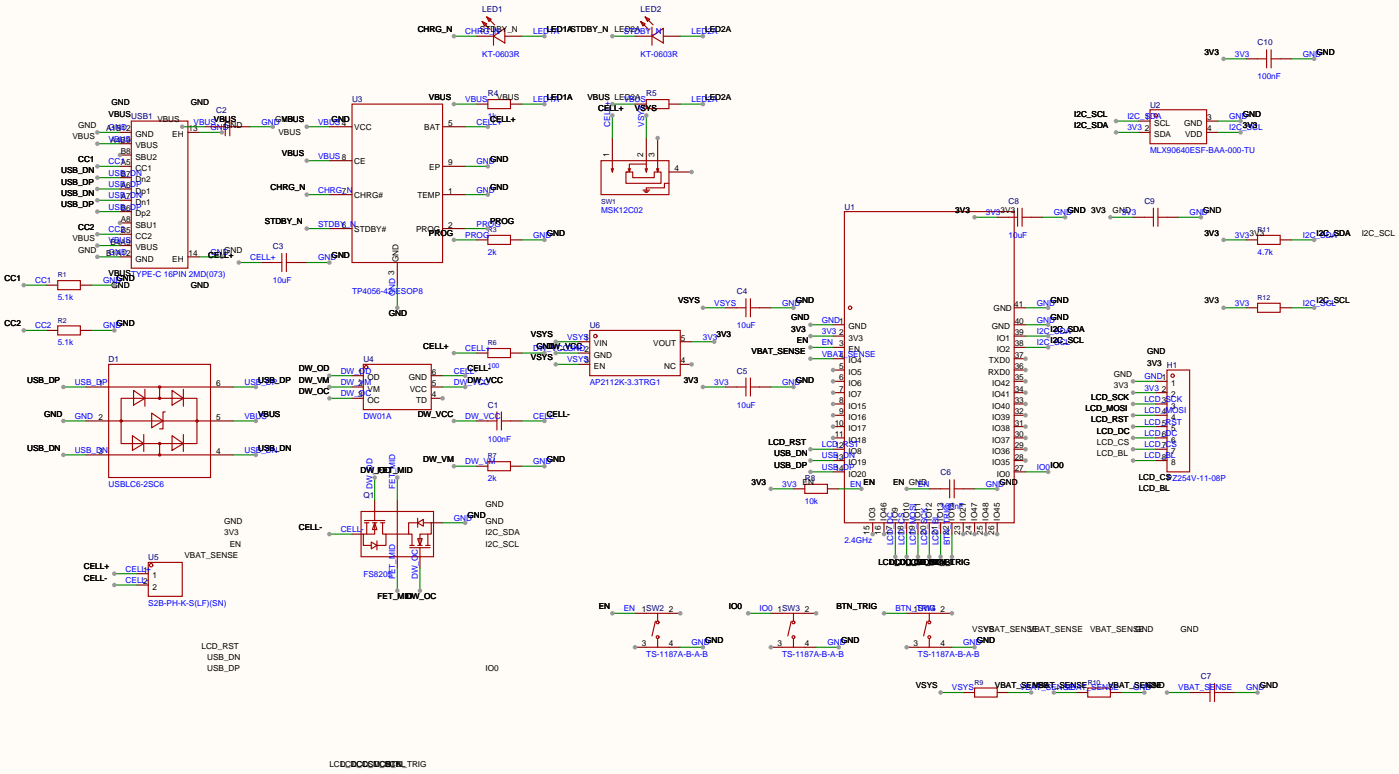
[picture p33: page 1]
