MonkeyBoy122/ThermalCamara/(commit log)

2026-10-11 Add bill of materials for project coAdd bom.csvmponents
2026-10-11 Update README with images and open items
    Added images and open items list for board ordering.
2026-10-11 aDDED PCB
2026-10-11 Organize repo into pcb, cad and images folders
2026-10-11 Finish reorganizing: move CAD to cad/, docs to docs/, BOM and EasyEDA export into pcb/, fix README paths
